adrianhelfer/Autocast/Utilities/USB_overlay.pdf

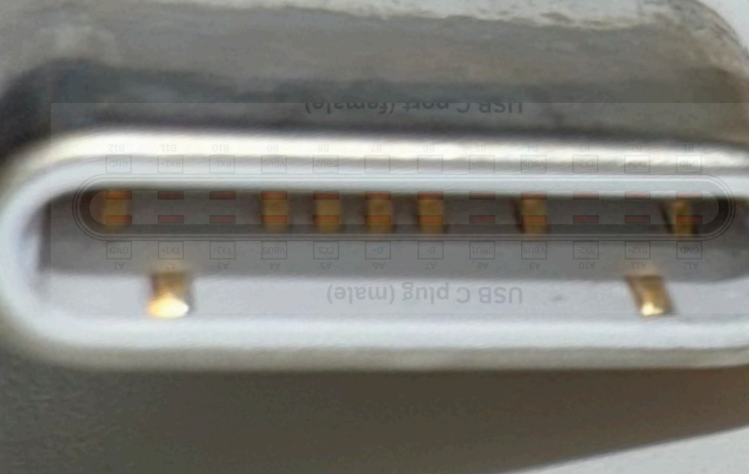
[picture p1: page 1]
