adrianhelfer/Autocast/Display/PCB_Label.png

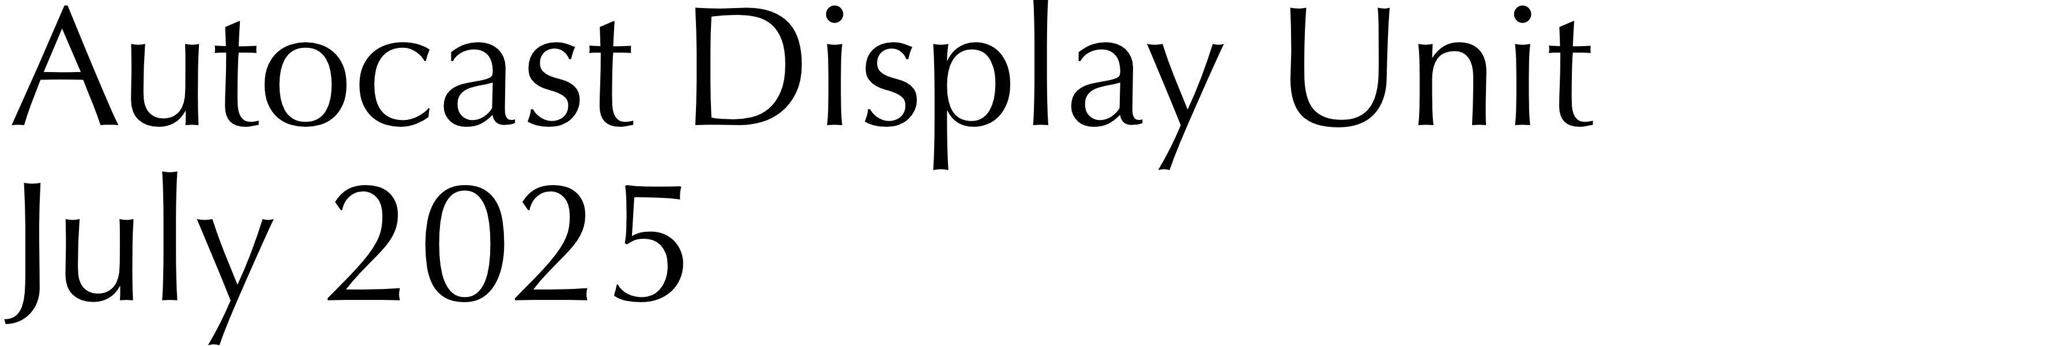
Display/PCB_Label.png
