adrianhelfer/Autocast/Display/PCB_Label_Caps.png

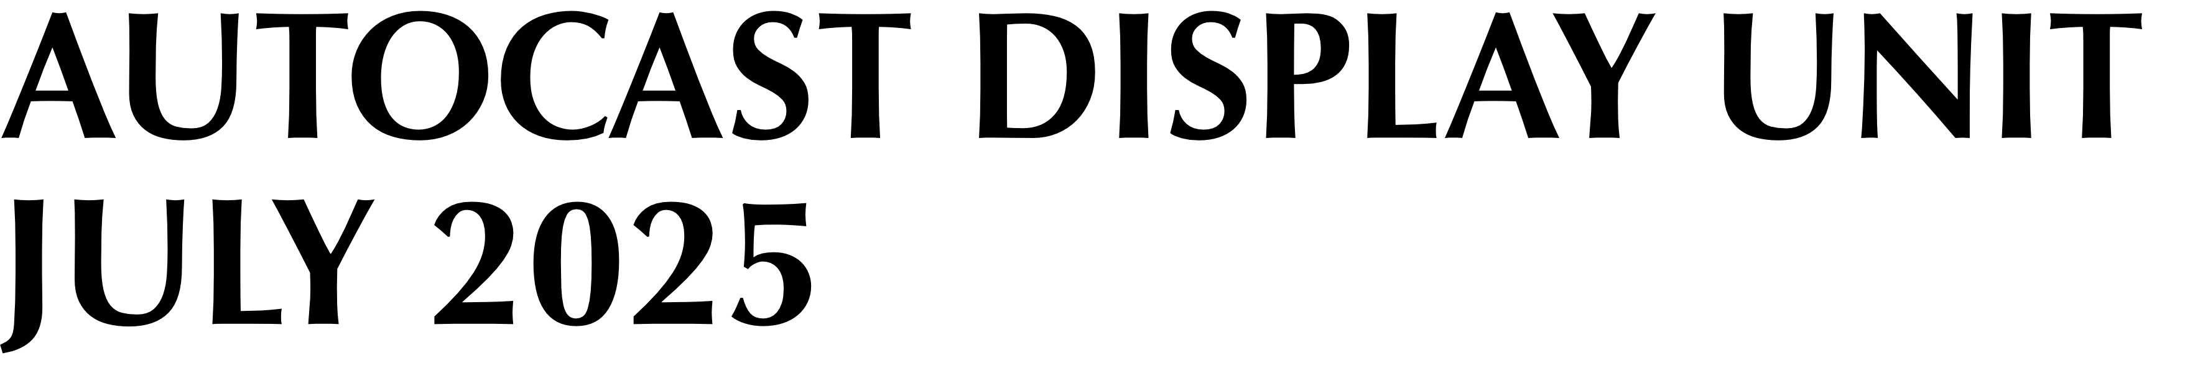
Display/PCB_Label_Caps.png
