adrianhelfer/Autocast/EVT/DAC_EVT/silkscreen/pcb_label.png

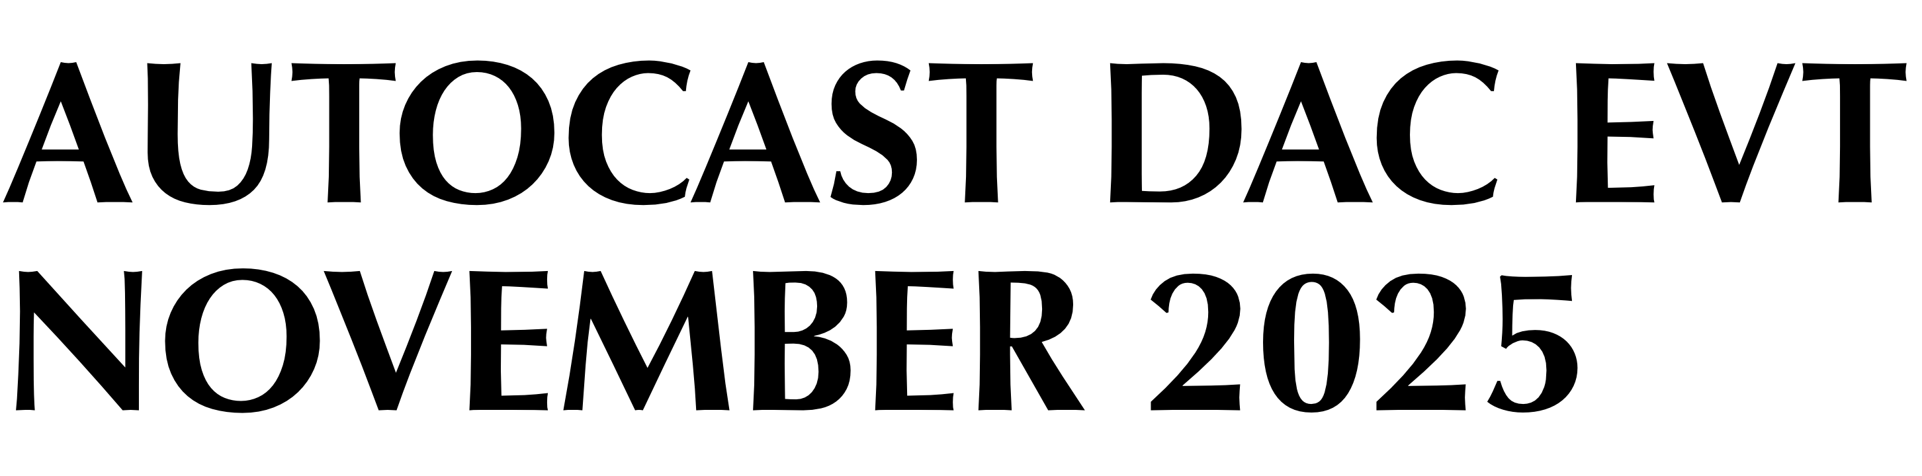
EVT/DAC_EVT/silkscreen/pcb_label.png
