adrianhelfer/Autocast/Playback_Control_EVT/PCB_label.png

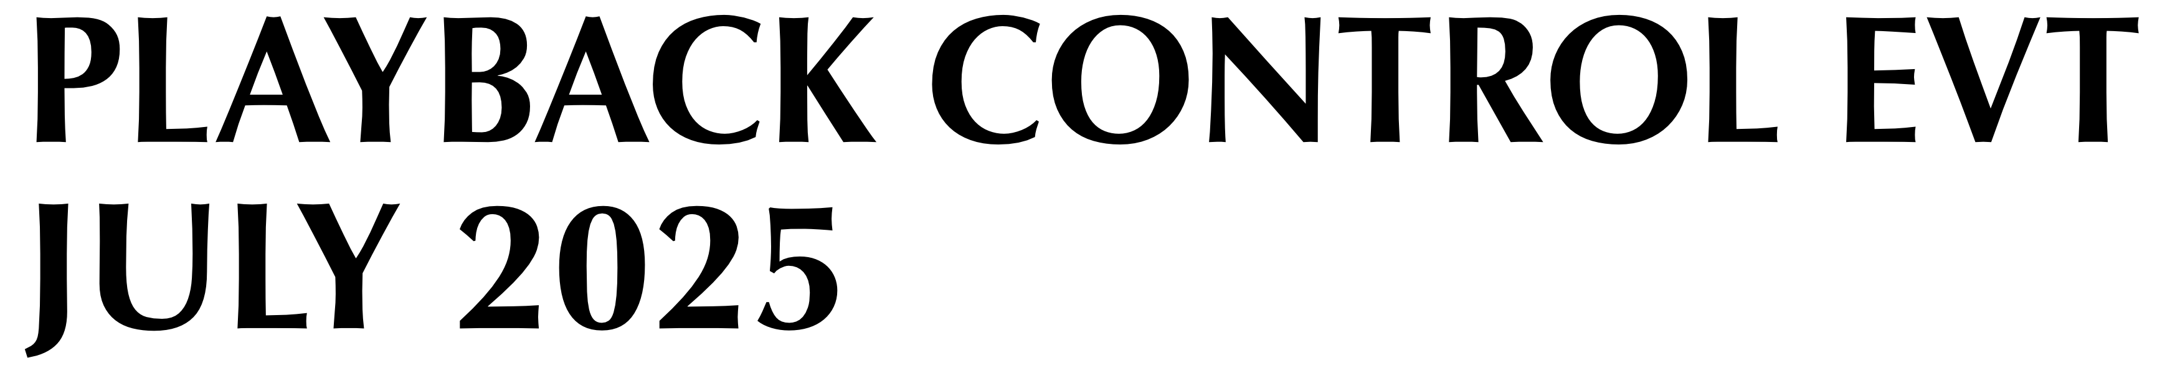
Playback_Control_EVT/PCB_label.png
