adrianhelfer/Autocast/Playback_Control_EVT/play_pause.png

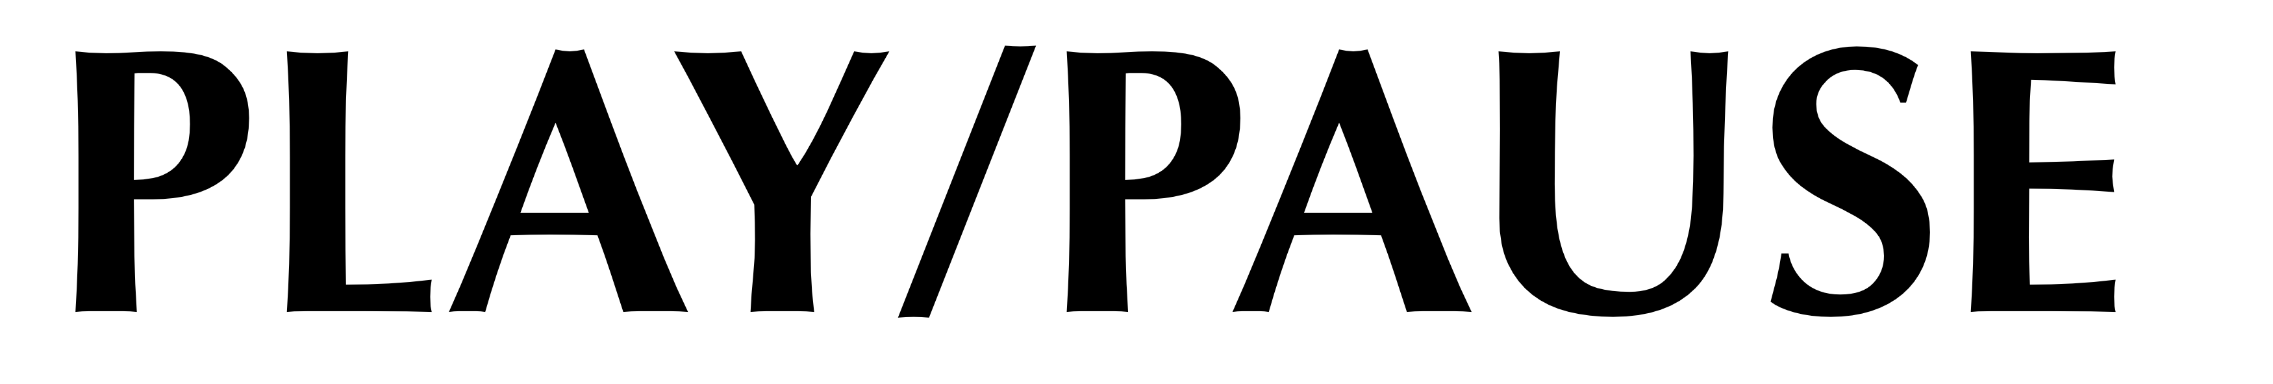
Playback_Control_EVT/play_pause.png
