adrianhelfer/Autocast/Playback_Control_EVT/rewind.png

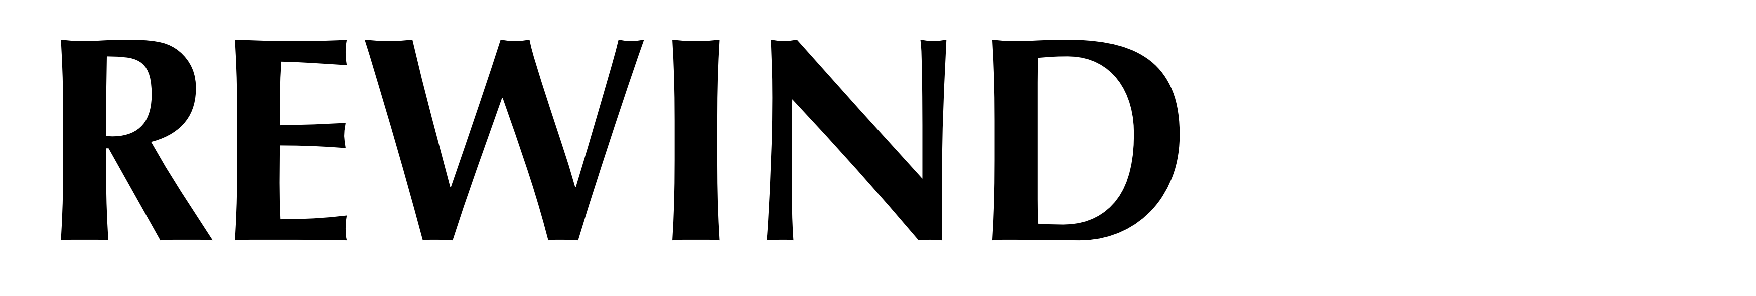
Playback_Control_EVT/rewind.png
