adrianhelfer/Autocast/Playback_Control_EVT/skip.png

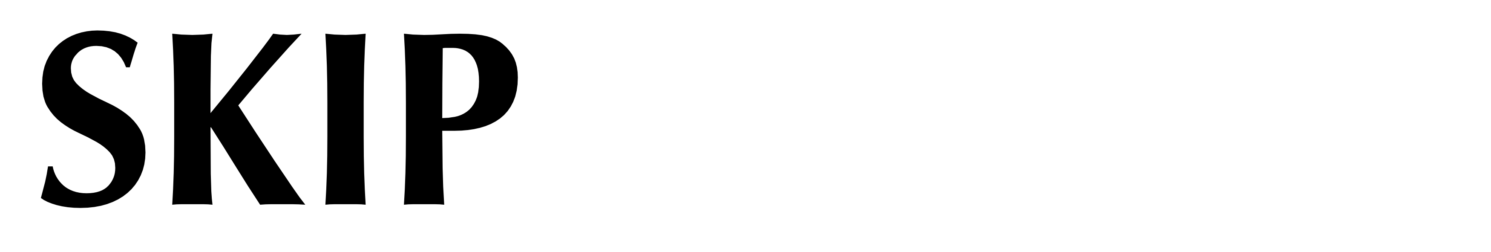
Playback_Control_EVT/skip.png
