adrianhelfer/Autocast/Playback_Control_EVT/vol_down.png

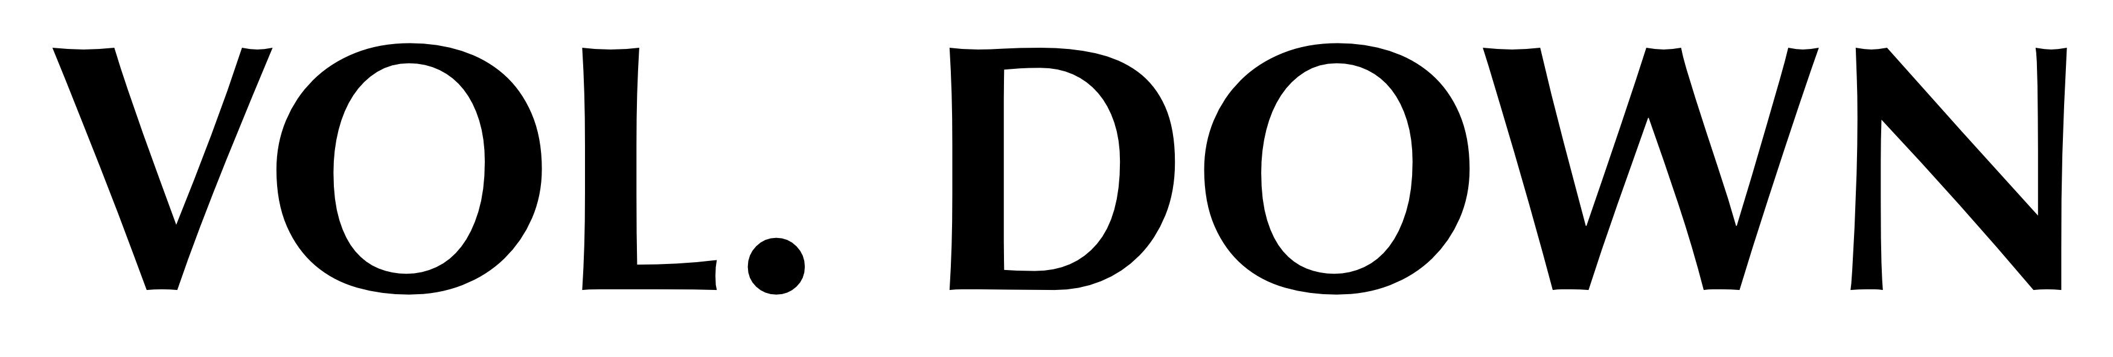
Playback_Control_EVT/vol_down.png
