adrianhelfer/Autocast/Playback_Control_EVT/vol_up.png

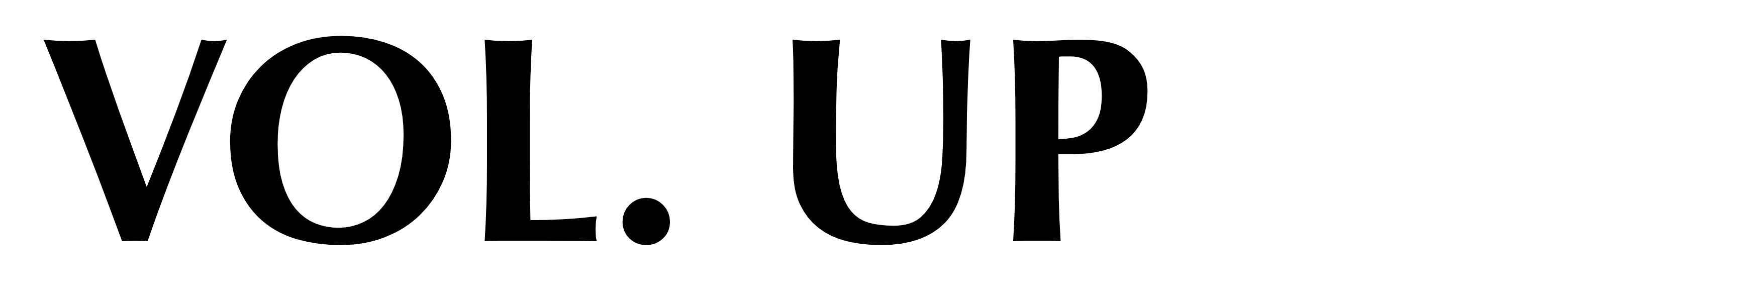
Playback_Control_EVT/vol_up.png
