adrianhelfer/Autocast/Utilities/ICSP/5843681079754166512_121.jpg

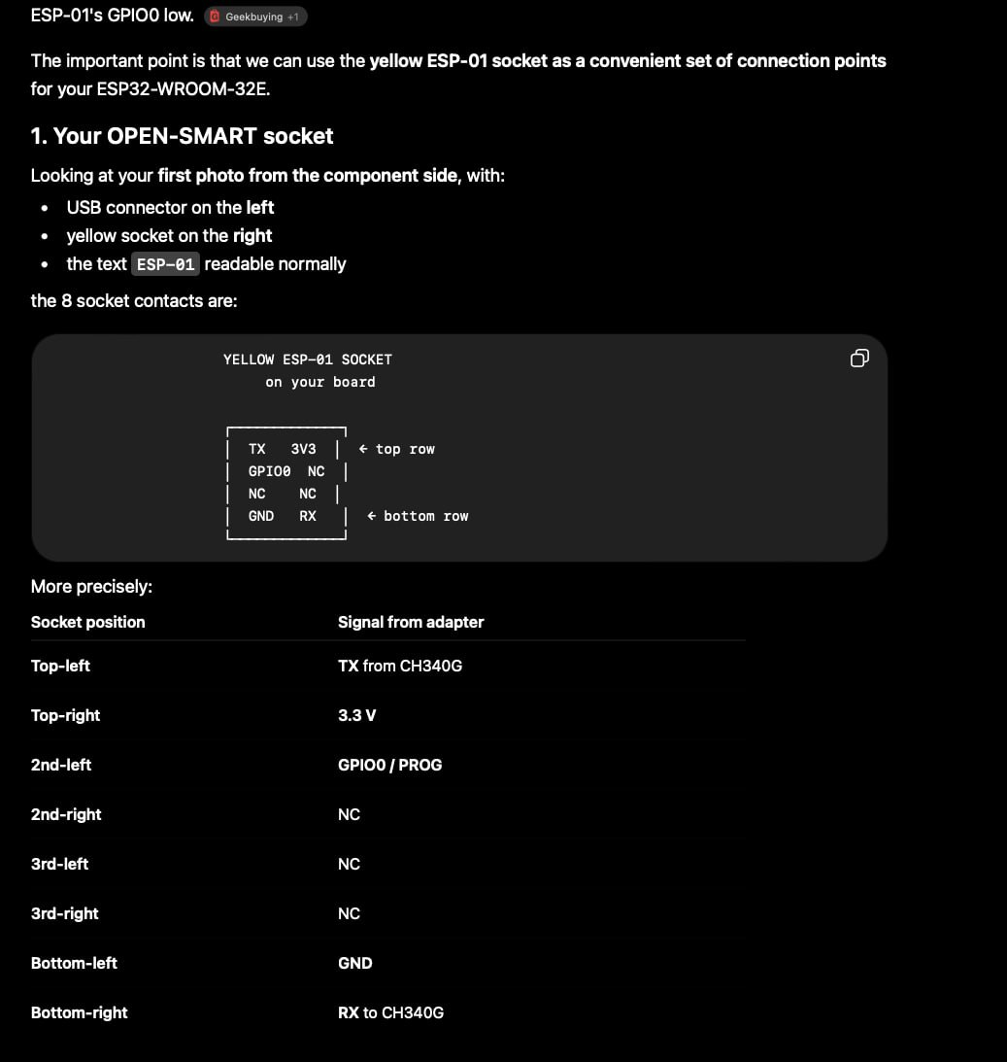
Utilities/ICSP/5843681079754166512_121.jpg
