adrianhelfer/Autocast/Utilities/ICSP/5843681079754166513_121.jpg

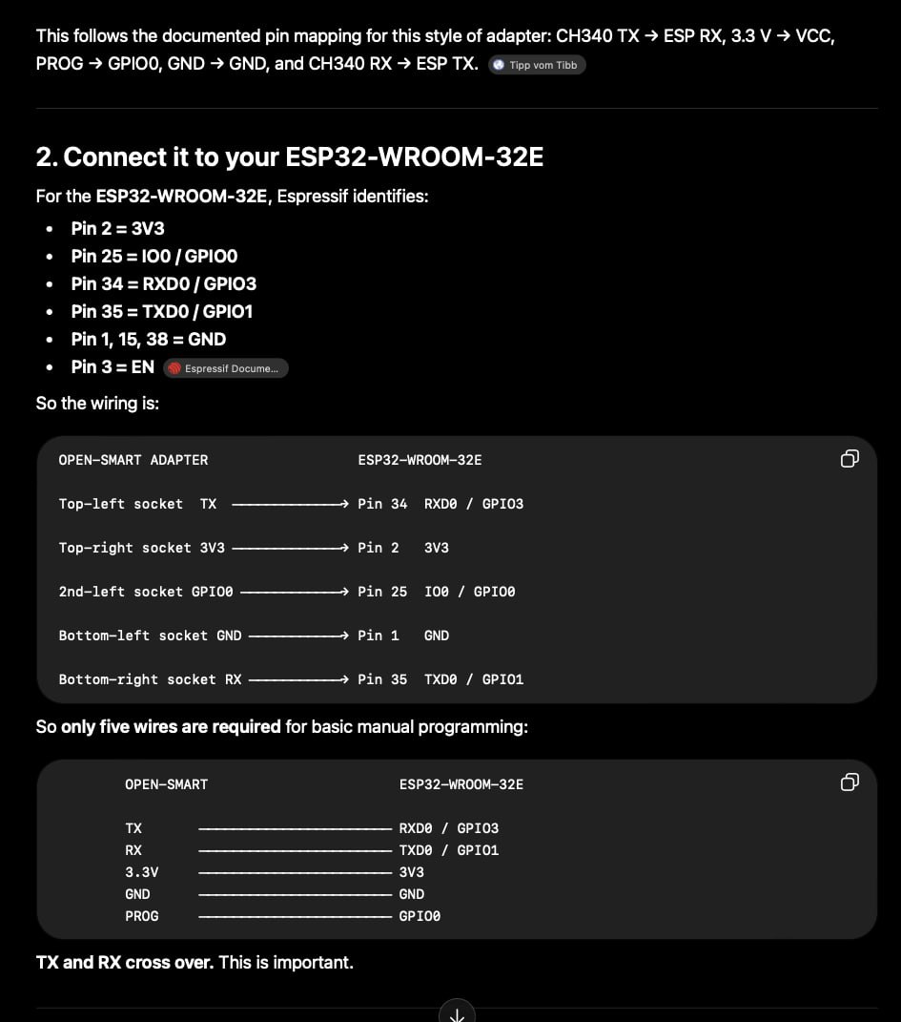
Utilities/ICSP/5843681079754166513_121.jpg
