adrianhelfer/Autocast/Utilities/ICSP/5843681079754166514_121.jpg

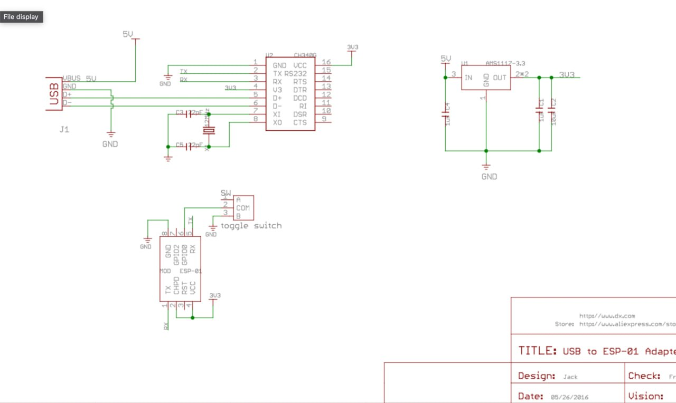
Utilities/ICSP/5843681079754166514_121.jpg
