adrianhelfer/Autocast/Utilities/ICSP/5843681079754166515_120.jpg

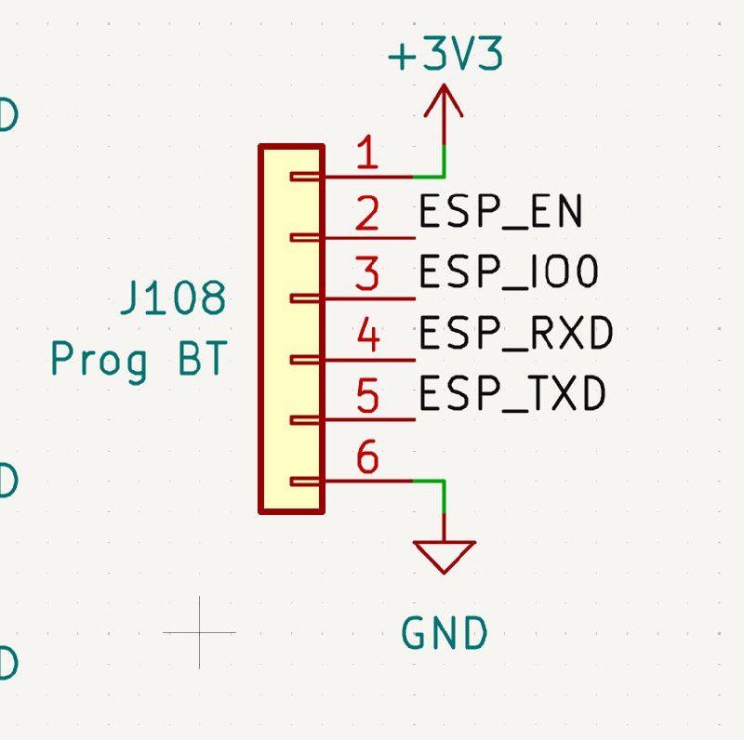
Utilities/ICSP/5843681079754166515_120.jpg
