adrianhelfer/Autocast/Display/production/bom.csv

Designator | Footprint | Quantity | Value | LCSC Part #
C1, C10, C11, C12, C13, C14, C15, C16, C17, C18, C19, C2, C20, C21, C22, C23, C24, C25, C26, C27, C28, C29, C3, C30, C31, C32, C33, C34, C35, C36, C37, C38, C39, C4, C40, C41, C42, C43, C44, C45, C46, C47, C48, C49, C5, C50, C51, C52, C53, C54, C55, C56, C6, C7, C8, C9 | 0201 | 56 | 100n | C49062
J1 | CON_2004850460_MOL | 1 | Conn_01x60
J2, J3 | CONN_12402032E202A_AMP | 2 | 12402032E202A
R1, R10, R100, R101, R102, R103, R104, R105, R106, R107, R108, R109, R11, R110, R111, R112, R113, R114, R115, R116, R117, R118, R119, R12, R120, R121, R122, R123, R124, R125, R126, R127, R128, R129, R13, R130, R131, R132, R133, R134, R135, R136, R137, R138, R139, R14, R140, R141, R142, R143, R144, R145, R146, R147, R148, R149, R15, R150, R151, R152, R153, R154, R155, R156, R157, R158, R159, R16, R160, R161, R162, R163, R164, R165, R166, R167, R168, R169, R17, R170, R171, R172, R173, R174, R175, R176, R177, R178, R179, R18, R180, R181, R182, R183, R184, R185, R186, R187, R188, R189, R19, R190, R191, R192, R193, R194, R195, R196, R197, R198, R199, R2, R20, R200, R201, R202, R203, R204, R205, R206, R207, R208, R209, R21, R210, R211, R212, R213, R214, R215, R216, R217, R218, R219, R22, R220, R221, R222, R223, R224, R225, R226, R227, R228, R229, R23, R230, R231, R232, R233, R234, R235, R236, R237, R238, R239, R24, R240, R241, R242, R243, R244, R245, R246, R247, R248, R249, R25, R250, R251, R252, R253, R254, R255, R256, R257, R258, R259, R26, R260, R261, R262, R263, R264, R265, R266, R267, R268, R269, R27, R270, R271, R272, R273, R274, R275, R276, R277, R278, R279 | 0402 | 200 | 100 | C25076
R28, R280, R281, R282, R283, R284, R285, R286, R287, R288, R289, R29, R290, R291, R292, R293, R294, R295, R296, R297, R298, R299, R3, R30, R300, R301, R302, R303, R304, R305, R306, R307, R308, R309, R31, R310, R311, R312, R313, R314, R315, R316, R317, R318, R319, R32, R320, R321, R322, R323, R324, R325, R326, R327, R328, R329, R33, R330, R331, R332, R333, R334, R335, R336, R337, R338, R339, R34, R340, R341, R342, R343, R344, R345, R346, R347, R348, R349, R35, R350, R351, R352, R353, R354, R355, R356, R357, R358, R359, R36, R360, R361, R362, R363, R364, R365, R366, R367, R368, R369, R37, R370, R371, R372, R373, R374, R375, R376, R377, R378, R379, R38, R380, R381, R382, R383, R384, R385, R386, R387, R388, R389, R39, R390, R391, R392, R393, R394, R395, R396, R397, R398, R399, R4, R40, R400, R401, R402, R403, R404, R405, R406, R407, R408, R409, R41, R410, R411, R412, R413, R414, R415, R416, R417, R418, R419, R42, R420, R43, R44, R45, R46, R47, R48, R49, R5, R50, R51, R52, R53, R54, R55, R56, R57, R58, R59, R6, R60, R61, R62, R63, R64, R65, R66, R67, R68, R69, R7, R70, R71, R72, R73, R74, R75, R76, R77, R78, R79, R8, R80 | 0402 | 200 | 100 | C25076
R81, R82, R83, R84, R85, R86, R87, R88, R89, R9, R90, R91, R92, R93, R94, R95, R96, R97, R98, R99 | 0402 | 20 | 100 | C25076
S1, S2, S3, S4, S5 | SW_TL2230EEF100 | 5 | TL2230EEF100
SEGD1, SEGD10, SEGD11, SEGD12, SEGD13, SEGD14, SEGD15, SEGD16, SEGD17, SEGD18, SEGD19, SEGD2, SEGD20, SEGD21, SEGD22, SEGD23, SEGD24, SEGD25, SEGD26, SEGD27, SEGD28, SEGD3, SEGD4, SEGD5, SEGD6, SEGD7, SEGD8, SEGD9 | ACPSC04-41SEKWA | 28 | ~
U1, U10, U11, U12, U13, U14, U15, U16, U17, U18, U19, U2, U20, U21, U22, U23, U24, U25, U26, U27, U28, U29, U3, U30, U31, U32, U33, U34, U35, U36, U37, U38, U39, U4, U40, U41, U42, U43, U44, U45, U46, U47, U48, U49, U5, U50, U51, U52, U53, U54, U55, U56, U6, U7, U8, U9 | TSSOP-16_4.4x5mm_P0.65mm | 56 | 74HC595
