adrianhelfer/Autocast/mCAD/Display-Assembly.FCStd

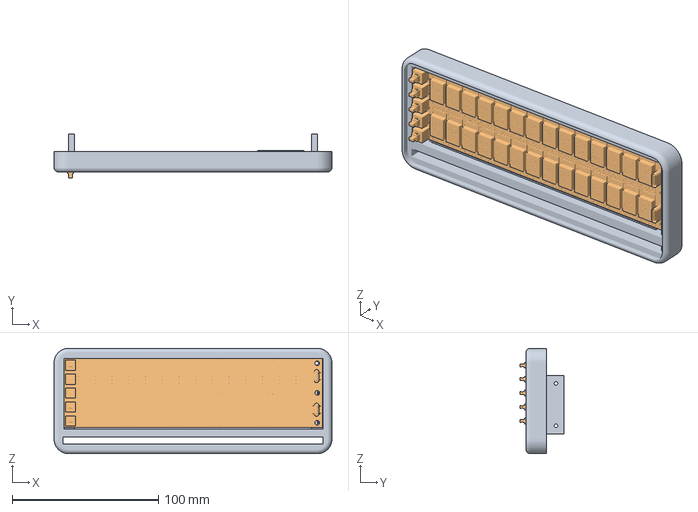
[picture p15: CAD file, 2026-10-08]
mCAD/Display-Assembly.FCStd
190.0 x 30.1 x 72.0 mm
Display001
