adrianhelfer/Autocast/Display/3D-Models/ACPSX04-41.STEP

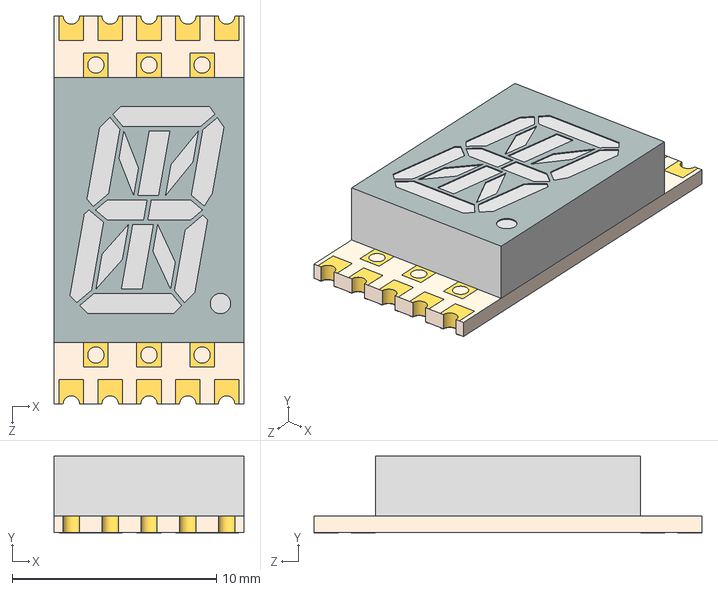
[picture p16: CAD file, 2025-07-09]
Display/3D-Models/ACPSX04-41.STEP
9.30 x 3.77 x 19.0 mm
