adrianhelfer/Autocast/EVT/DAC_EVT/3d_models/SMV_z90.stp

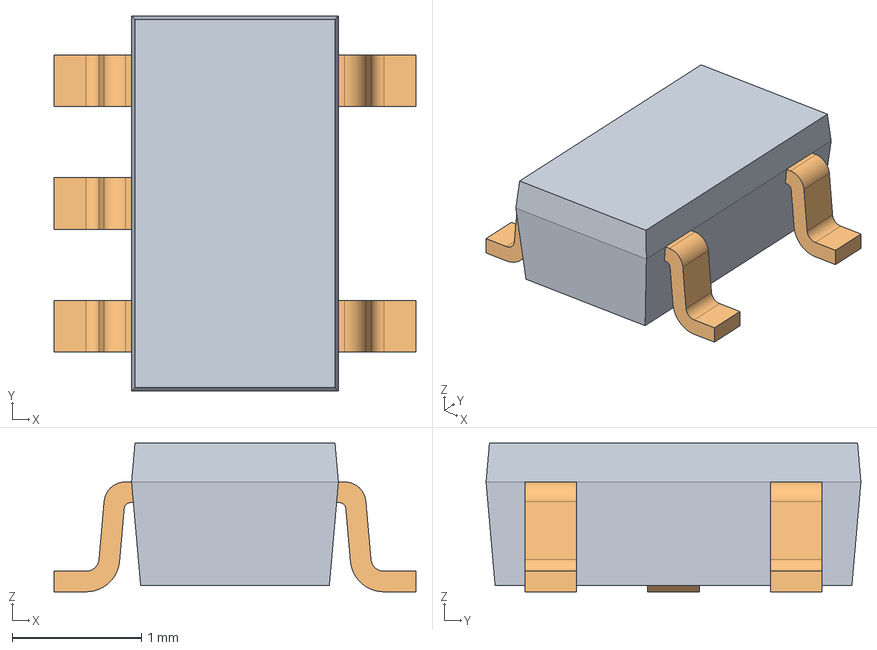
[picture p17: CAD file, 2025-11-18]
EVT/DAC_EVT/3d_models/SMV_z90.stp
2.80 x 2.90 x 1.15 mm
