adrianhelfer/Autocast/EVT/Lever_EVT/Slider.step

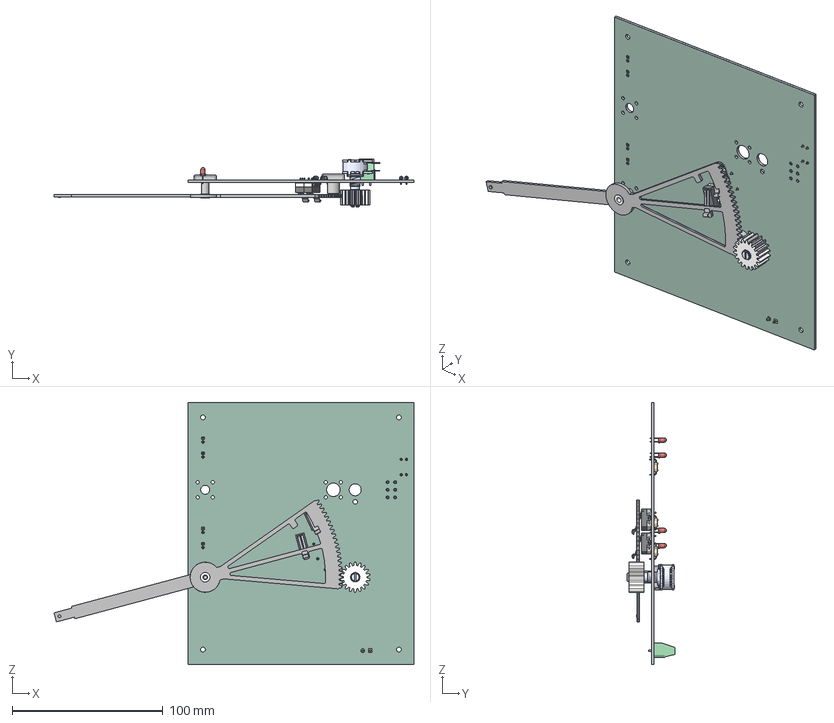
[picture p18: CAD file, 2026-09-19]
EVT/Lever_EVT/Slider.step
238.8 x 31.6 x 174.0 mm
Spur Gear (18 teeth)
Spur Gear (18 teeth) (1)
Spur Gear (180 teeth)
PTN16_2 BUSHING
PTN16-A_2 HOUSING
PTN16_20K1_SHAFT
R_Axial_DIN0207_L6.3mm_D2.5mm_P10.16mm_Horizontal x 4
TerminalBlock_Phoenix_MKDS-1,5-2_1x02_P5.00mm_Horizontal
LED_D3.0mm x 4
Bottom001 x 2
Top001 x 2
Plunger001 x 2
Lever_16U001 x 2
Pin_NO005 x 2
Pin_C005 x 2
Pin_NC005 x 2
Lever_EVT_copper
Lever_EVT_silkscreen
Lever_EVT_silkscreen_1
Lever_EVT_soldermask
Lever_EVT_soldermask_1
Lever_EVT_PCB
