adrianhelfer/Autocast/EVT/USB_Audio_EVT/3d-models/CSTNE12M0G55A000R0.step

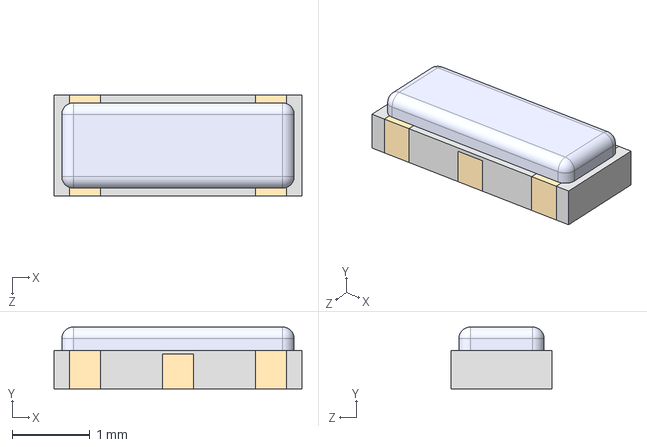
[picture p19: CAD file, 2026-09-19]
EVT/USB_Audio_EVT/3d-models/CSTNE12M0G55A000R0.step
3.20 x 0.8 x 1.30 mm
