adrianhelfer/Autocast/mCAD/button-caps/play-pause.FCStd

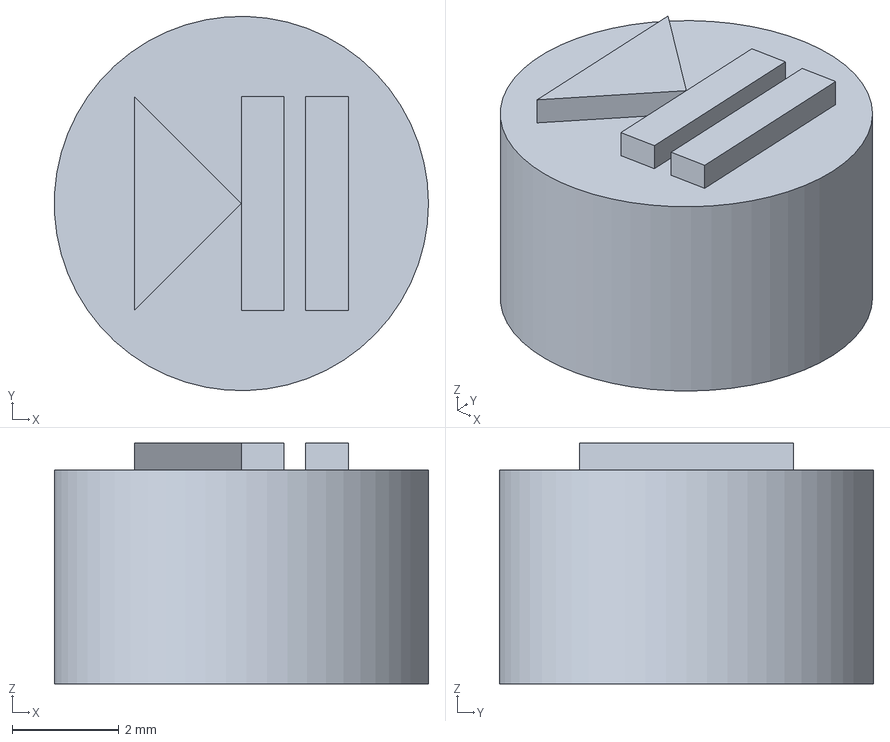
[picture p20: CAD file, 2026-10-08]
mCAD/button-caps/play-pause.FCStd
6.99 x 7.00 x 4.50 mm
