adrianhelfer/Autocast/mCAD/slide-selector/potentiometer_attachment-Body.stl

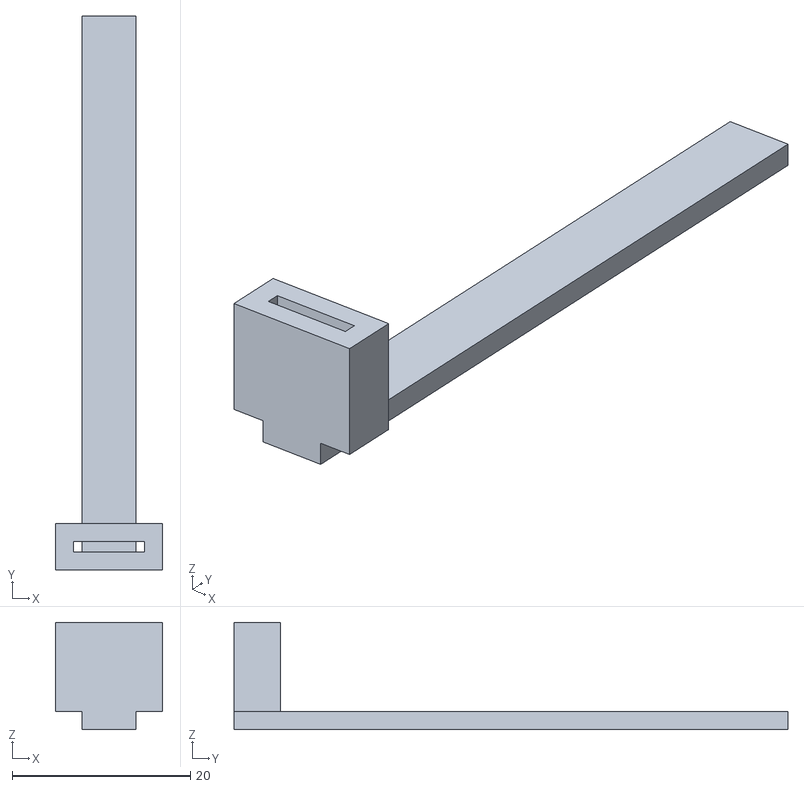
[picture p21: CAD file, 2026-10-06]
mCAD/slide-selector/potentiometer_attachment-Body.stl
12.0 x 62.1 x 12.0
