adrianhelfer/Autocast/PSU_EVT/3D_Models/STL6P3LLH6.step

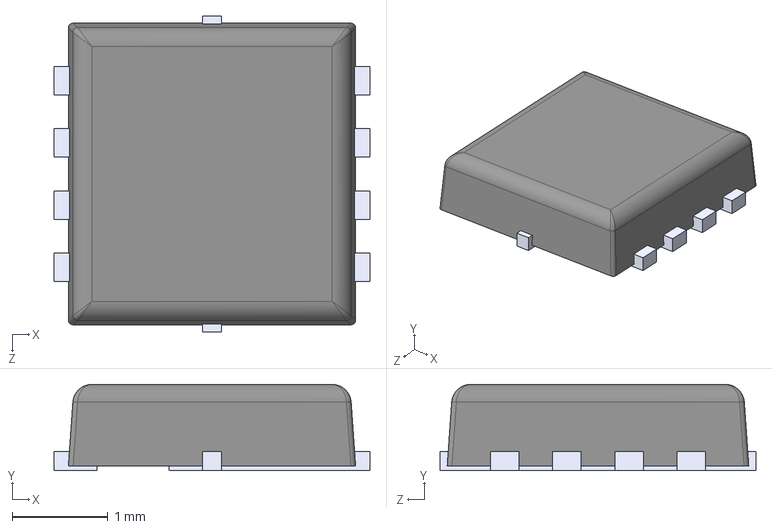
[picture p22: CAD file, 2025-07-14]
PSU_EVT/3D_Models/STL6P3LLH6.step
3.30 x 0.9 x 3.30 mm
