adrianhelfer/Autocast/EVT/DAC_EVT/3d_models/SJ1-3523N.step

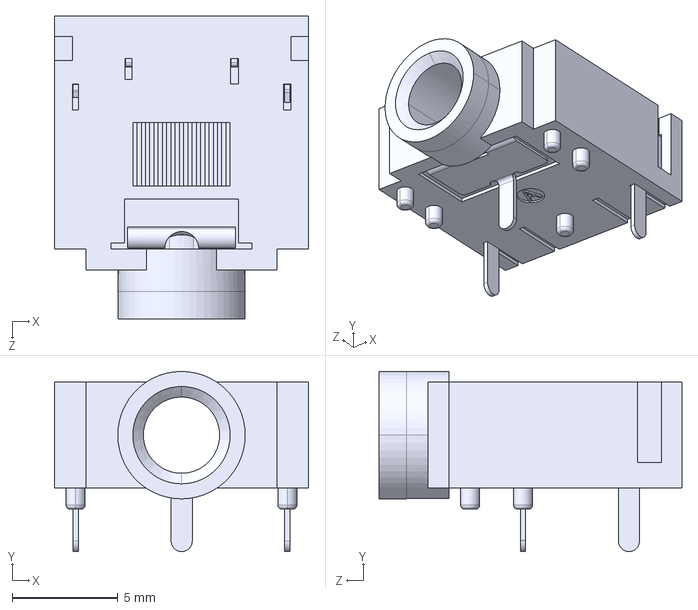
[picture p23: CAD file, 2025-11-18]
EVT/DAC_EVT/3d_models/SJ1-3523N.step
12.0 x 8.51 x 14.3 mm
