adrianhelfer/Autocast/EVT/Lever_EVT/Lever_EVT.step

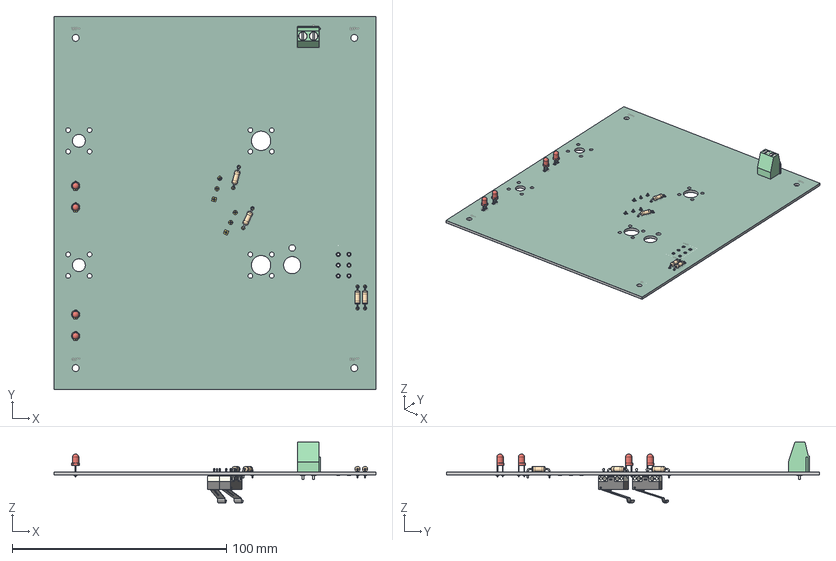
[picture p24: CAD file, 2026-09-19]
EVT/Lever_EVT/Lever_EVT.step
150.0 x 174.0 x 28.3 mm
R_Axial_DIN0207_L6.3mm_D2.5mm_P10.16mm_Horizontal x 4
TerminalBlock_Phoenix_MKDS-1,5-2_1x02_P5.00mm_Horizontal
LED_D3.0mm x 4
Bottom001 x 2
Top001 x 2
Plunger001 x 2
Lever_16U001 x 2
Pin_NO005 x 2
Pin_C005 x 2
Pin_NC005 x 2
Lever_EVT_copper
Lever_EVT_silkscreen x 2
Lever_EVT_soldermask x 2
Lever_EVT_PCB
