adrianhelfer/Autocast/EVT/USB_Audio_EVT/3d-models/PCM2706CPJTR.step

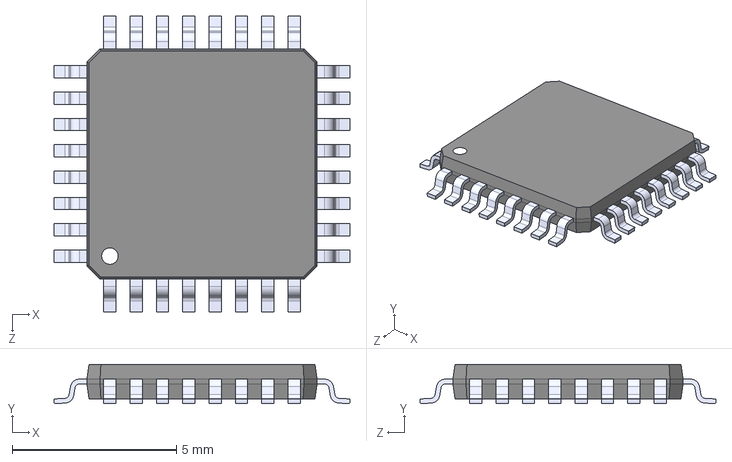
[picture p25: CAD file, 2026-09-19]
EVT/USB_Audio_EVT/3d-models/PCM2706CPJTR.step
9.00 x 1.20 x 9.00 mm
