adrianhelfer/Autocast/mCAD/button-caps/plus.FCStd

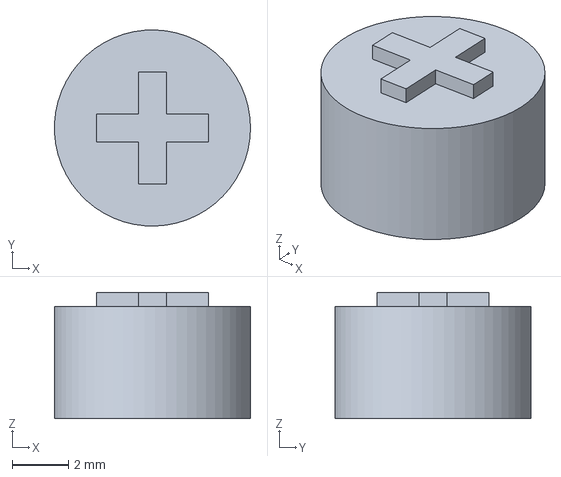
[picture p26: CAD file, 2026-10-08]
mCAD/button-caps/plus.FCStd
6.99 x 7.00 x 4.50 mm
