adrianhelfer/Autocast/mCAD/Display-Glass.FCStd

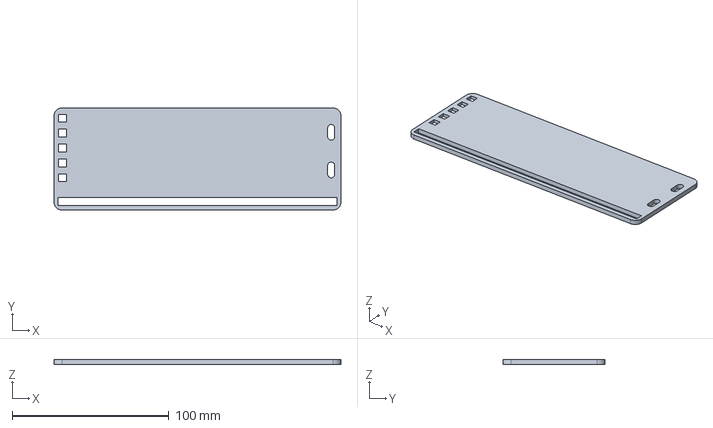
[picture p27: CAD file, 2026-10-08]
mCAD/Display-Glass.FCStd
183.0 x 65.0 x 3.00 mm
