adrianhelfer/Autocast/mCAD/slide-selector/carriage_attachment-Body.stl

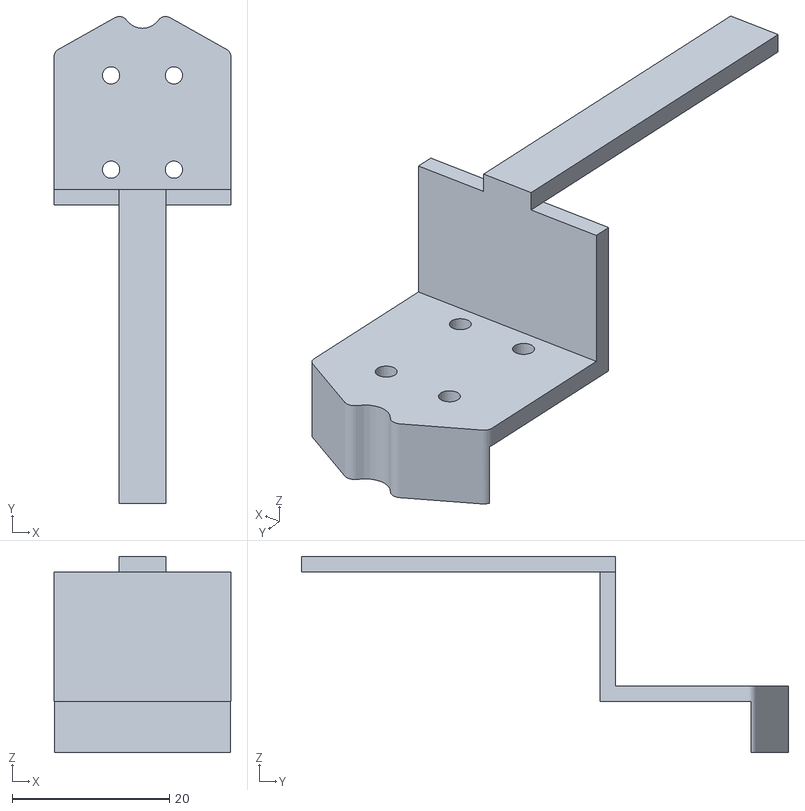
[picture p28: CAD file, 2026-10-06]
mCAD/slide-selector/carriage_attachment-Body.stl
22.5 x 62.0 x 25.0
