adrianhelfer/Autocast/EVT/USB_Audio_EVT/3d-models/TL2230EEF100.STEP

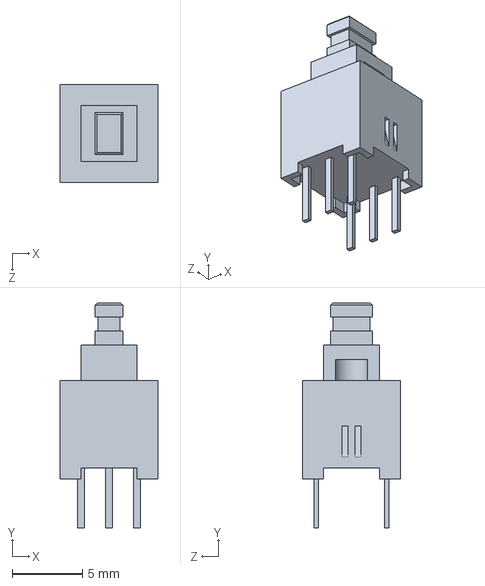
[picture p29: CAD file, 2025-07-09]
EVT/USB_Audio_EVT/3d-models/TL2230EEF100.STEP
7.00 x 16.0 x 7.00 mm
