adrianhelfer/Autocast/(list of files, cad)

Other CAD files:
mCAD/button-caps/rewind.FCStd
mCAD/slide-selector/carriage_attachment.FCStd
mCAD/button-caps/minus.FCStd
mCAD/button-caps/forward.FCStd
Display/3D-Models/2004850460.stp
EVT/Lever_EVT/Slider.f3z
EVT/USB_Audio_EVT/3d-models/12402032E202A.STEP
mCAD/Display-Assembly.stl
mCAD/Display-Glass.stl
mCAD/button-caps/forward.stl
mCAD/button-caps/minus.stl
mCAD/button-caps/play-pause.stl
mCAD/button-caps/plus.stl
mCAD/button-caps/rewind.stl
