adrianhelfer/Autocast/Utilities/Radio_Wiring.pdf

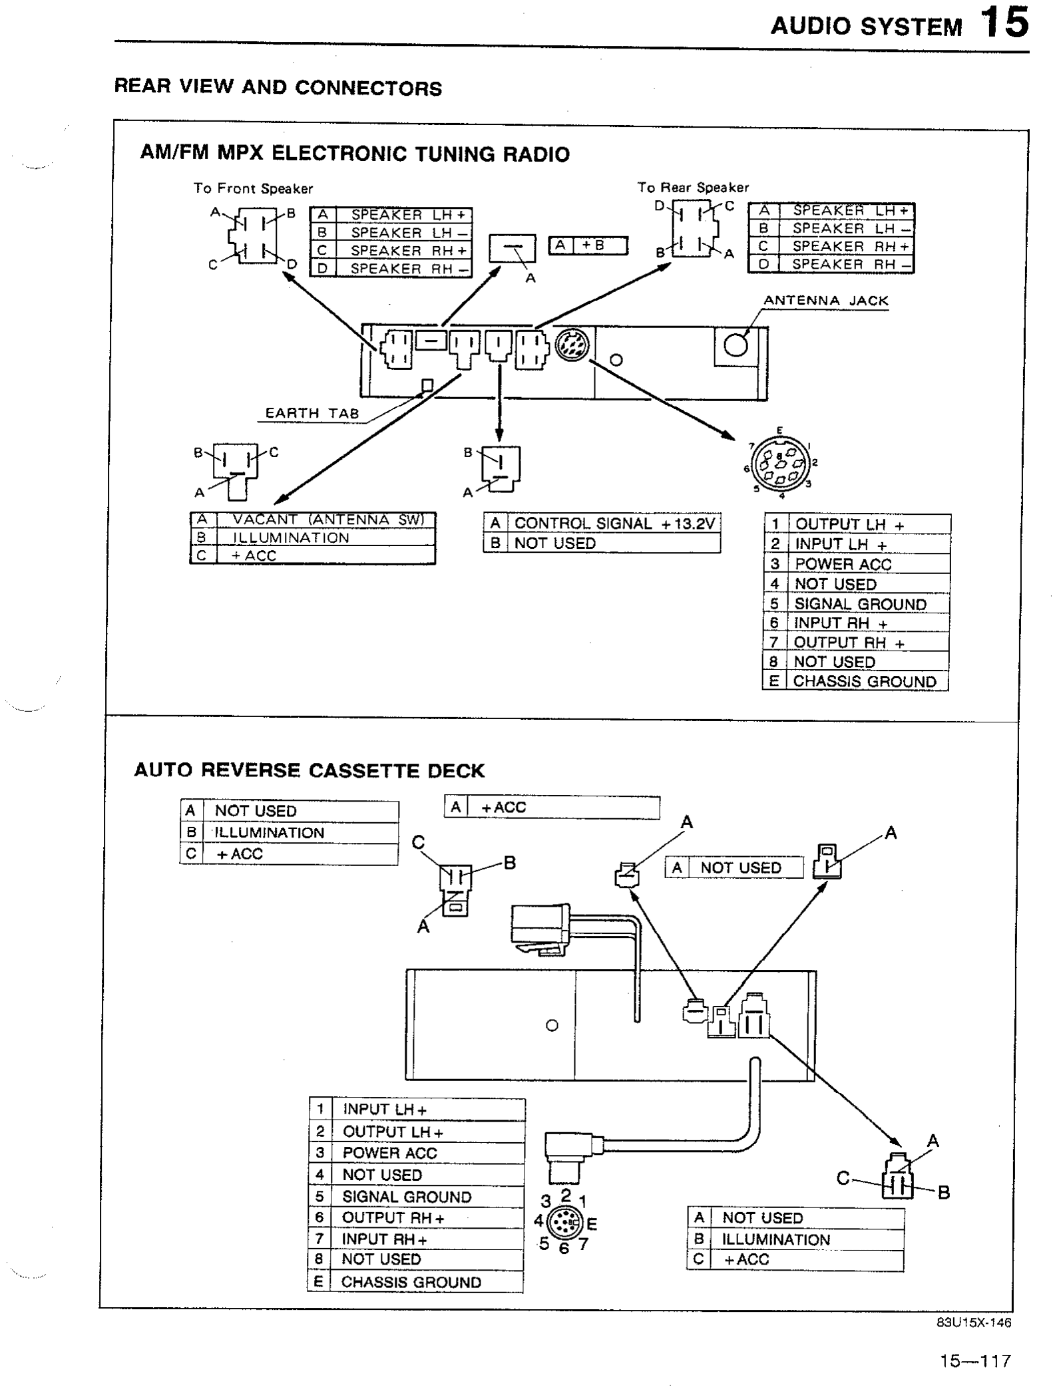
[picture p30: page 1]

AUDIO | SYSTEM | 15

REAR VIEW AND CONNECTORS

AM/FM | MPX ELECTRONIC | TUNING | RADIO
TO Front Speaker | To Rear Speaker
AUTO | REVERSECASSETTEDECK

83”15X-14

15-117
