adrianhelfer/Autocast/EVT/USB_Audio_EVT/fabrication/layers.pdf

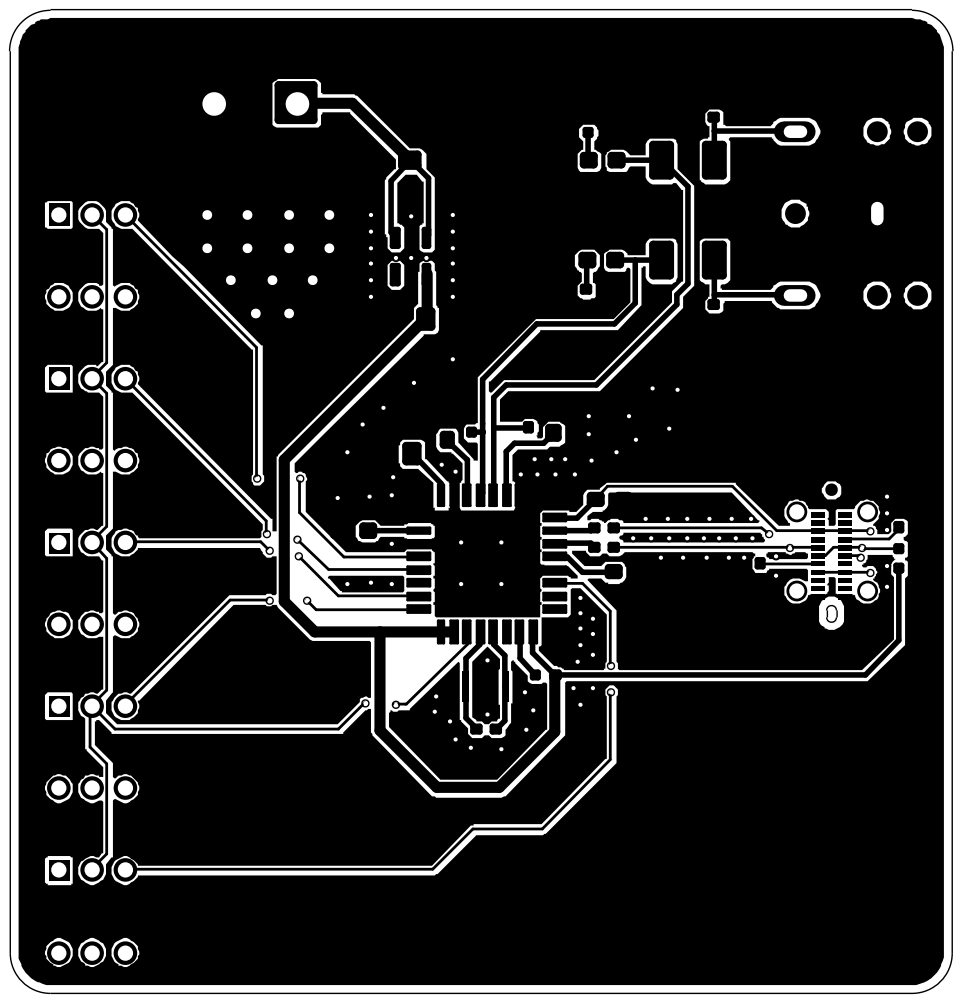
[picture p31: page 1]

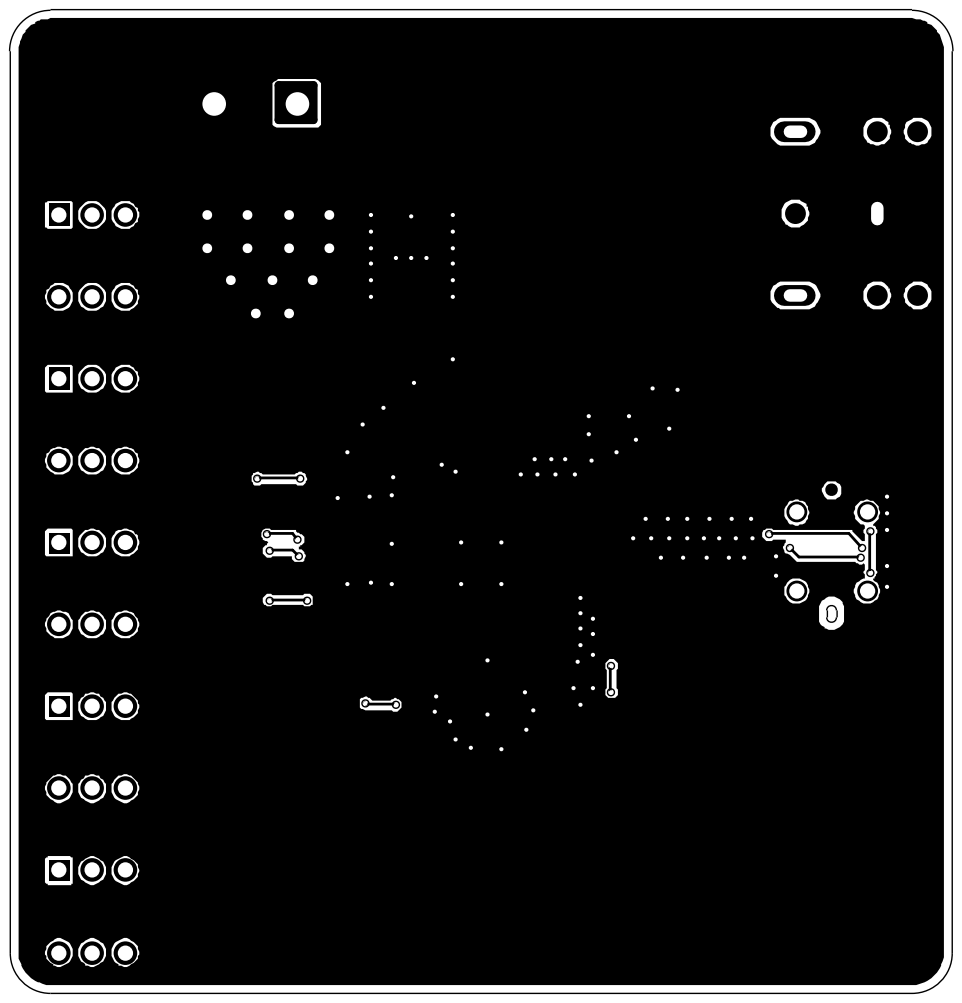
[picture p32: page 2]
