adrianhelfer/Autocast/Utilities/display_drawings.pdf

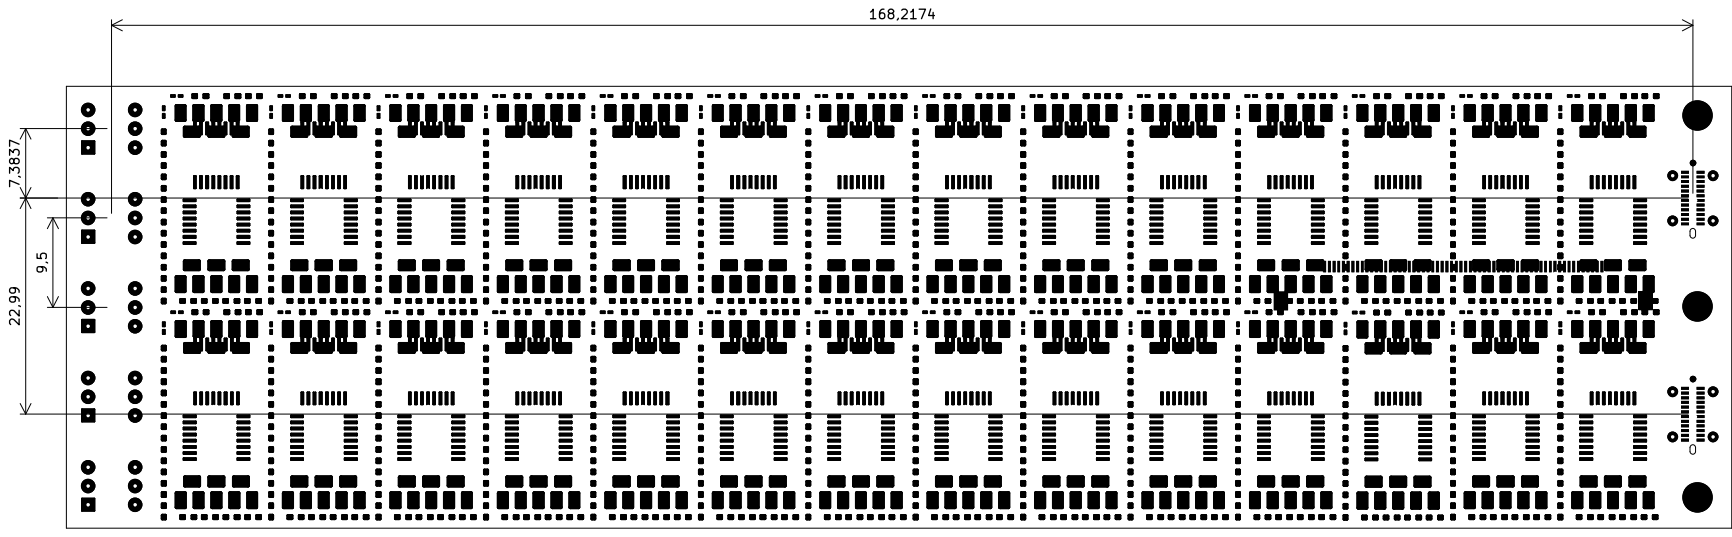
[picture p33: page 1]
