adrianhelfer/Autocast/Software/Autocast/Autocast.ino

#include <Arduino.h>
#include <Wire.h>
#include "BluetoothA2DPSink.h"
#include "AutocastDisplay.h"

// USB current monitor
#define USB_POWER_MONITOR_SDA_PIN 32
#define USB_POWER_MONITOR_SCL_PIN 33
#define INA226_ADDR 0x40          // Default address (A0=A1=GND)
#define SHUNT_RESISTOR_OHMS 0.01  // 0.01 ohm shunt
#define MAX_EXPECTED_USB_CURRENT_A 3.2

// ---------- INA226 register map ----------
#define INA226_REG_CONFIG 0x00
#define INA226_REG_SHUNT_V 0x01
#define INA226_REG_BUS_V 0x02
#define INA226_REG_POWER 0x03
#define INA226_REG_CURRENT 0x04
#define INA226_REG_CALIBRATION 0x05

float INA226_currentLSB;  // Amps per bit for the current register
float INA226_powerLSB;    // Watts per bit for the power register
int success = 0;
// ---------------------------------------------------------------------
// Pin definitions
// ---------------------------------------------------------------------
const uint8_t SENSOR_VP_PIN = 36;  // adjust to your actual wiring
const uint8_t SENSOR_VN_PIN = 39;

const int CONFIG_PIN_SER = 2;     // IO2  -> SER (serial data in)
const int CONFIG_PIN_SRCLK = 17;  // IO17 -> SRCLK (shift register clock)
const int CONFIG_PIN_RCLK = 13;   // IO13 -> RCLK (storage register clock / latch)

const int ILLUMINATION_SIGNAL_PIN = 4;  // HIGH when headlights or parking lights are switched on
const int DIMM_DISPLAY_PIN = 15;        // Display gets darker when set to HIGH

const int USB_DAC_CABLE_DETECT_A = 19;
const int USB_DAC_CABLE_DETECT_B = 21;

// Button order matches schematic but not the physical layout due to routing optimization
const int USER_BUTTON_1 = 12;
const int USER_BUTTON_2 = 14;
const int USER_BUTTON_3 = 27;
const int USER_BUTTON_4 = 34;
const int USER_BUTTON_5 = 35;

// ---- Bluetooth button configuration ----
// Set to LOW if your buttons pull the line to GND when pressed.
#define BUTTON_ACTIVE_LEVEL HIGH

const uint8_t BT_BTN_PREV = USER_BUTTON_1;
const uint8_t BT_BTN_PLAYPAUSE = USER_BUTTON_2;
const uint8_t BT_BTN_NEXT = USER_BUTTON_5;
const uint8_t BT_BTN_VOL_DOWN = USER_BUTTON_4;
const uint8_t BT_BTN_VOL_UP = USER_BUTTON_3;

const uint8_t BT_VOLUME_STEP = 10;
const unsigned long BT_REPEAT_DELAY_MS = 400;     // hold time before repeating
const unsigned long BT_REPEAT_INTERVAL_MS = 150;  // repeat rate while held

bool bt_is_connected = false;
bool bt_is_playing = false;

static const uint8_t BT_BUTTON_PINS[5] = {
  USER_BUTTON_1, USER_BUTTON_2, USER_BUTTON_3, USER_BUTTON_4, USER_BUTTON_5
};
static bool btn_last[5] = { false, false, false, false, false };
static unsigned long btn_press_time[5] = { 0, 0, 0, 0, 0 };
static unsigned long btn_last_repeat[5] = { 0, 0, 0, 0, 0 };

// Amplifier failure
const int AMP_FAIL_PIN = 16;

// =======================================================================
// TYPE DEFINITIONS (must precede all forward declarations / function use)
// =======================================================================

// ---- Top-level input selection state ----
enum class InputSelection : uint8_t {
  OFF,
  BLUETOOTH,
  USB,
  ERROR_STATE
};

// ---- Bits to shift into the configuration register ----
enum config_t {
  OFF_CONFIG = 0b00000000,
  BLUETOOTH_CONFIG = 0b00001011,
  USB_CONFIG = 0b00001111,  // USB DAC not on by default
  USB_DAC_EN_BITMASK = 0b00010000
} current_config;

// ---- Bluetooth-mode-local display state ----
enum bt_display_information_t {
  BT_NOT_CONNECTED,
  BT_NOW_PLAYING,
  BT_VOLUME_OVERLAY
};

struct TrackInfo {
  String title = "";
  String artist = "";
};

// =======================================================================
// FORWARD DECLARATIONS
// =======================================================================

// ---- State machine core ----
InputSelection decodeState(int vpState, int vnState);
void enterState(InputSelection s);
void exitState(InputSelection s);
void runState(InputSelection s);

// ---- OFF ----
void enterOffMode();
void exitOffMode();
void runOffMode();

// ---- BLUETOOTH ----
void enterBluetoothMode();
void exitBluetoothMode();
void runBluetoothMode();
void avrc_metadata_callback(uint8_t id, const uint8_t* text);
void connection_state_changed(esp_a2d_connection_state_t state, void* ptr);
void audio_state_changed(esp_a2d_audio_state_t state, void* ptr);

// ---- USB ----
void enterUsbMode();
void exitUsbMode();
void runUsbMode();

// ---- ERROR ----
void enterErrorMode();
void exitErrorMode();
void runErrorMode();

void shiftOutByte(uint8_t data, bool msbFirst = true) {
  for (int i = 0; i < 8; i++) {
    // Pick the correct bit depending on shift order
    uint8_t bit = msbFirst ? ((data >> (7 - i)) & 0x01)
                           : ((data >> i) & 0x01);

    digitalWrite(CONFIG_PIN_SER, bit);

    // Pulse SRCLK to shift the bit in
    digitalWrite(CONFIG_PIN_SRCLK, HIGH);
    delayMicroseconds(1);  // tiny settle time, optional at low speed
    digitalWrite(CONFIG_PIN_SRCLK, LOW);
  }

  // Latch the shifted data to the output pins
  digitalWrite(CONFIG_PIN_RCLK, HIGH);
  delayMicroseconds(1);
  digitalWrite(CONFIG_PIN_RCLK, LOW);
}


void load_config(config_t config) {
  current_config = config;
  shiftOutByte(config);
}

void enable_usb_dac() {
  load_config((config_t)(current_config | USB_DAC_EN_BITMASK));
}


void disable_usb_dac() {
  load_config((config_t)(current_config & ~USB_DAC_EN_BITMASK));
}

void ina226Write16(uint8_t reg, uint16_t value) {
  Wire.beginTransmission(INA226_ADDR);
  Wire.write(reg);
  Wire.write((value >> 8) & 0xFF);  // MSB first
  Wire.write(value & 0xFF);
  Wire.endTransmission();
}

int16_t ina226Read16(uint8_t reg) {
  Wire.beginTransmission(INA226_ADDR);
  Wire.write(reg);
  Wire.endTransmission(false);
  Wire.requestFrom(INA226_ADDR, (uint8_t)2);
  uint16_t value = 0;
  if (Wire.available() >= 2) {
    value = (Wire.read() << 8) | Wire.read();
  }
  return (int16_t)value;
}

void setupINA226() {
  // Current_LSB = MaxExpectedCurrent / 2^15
  INA226_currentLSB = MAX_EXPECTED_USB_CURRENT_A / 32768.0;
  INA226_powerLSB = INA226_currentLSB * 25.0;  // Power_LSB = 25 * Current_LSB (per datasheet)

  // Calibration = 0.00512 / (Current_LSB * Rshunt)
  uint16_t calValue = (uint16_t)(0.00512 / (INA226_currentLSB * SHUNT_RESISTOR_OHMS));
  ina226Write16(INA226_REG_CALIBRATION, calValue);

  // Config register: default reset value 0x4127 gives
  // avg=1, bus/shunt conv time=1.1ms, continuous shunt+bus mode.
  // Increase averaging for smoother readings, e.g. 0x4527 (avg=16).
  ina226Write16(INA226_REG_CONFIG, 0x4527);
  delay(100);
}


// =======================================================================
// GLOBALS
// =======================================================================

InputSelection autocast_input_selection = InputSelection::OFF;

// ---- Debounce configuration ----
const uint8_t DEBOUNCE_THRESHOLD = 5;         // consecutive agreeing samples required
const unsigned long SAMPLE_INTERVAL_MS = 10;  // time between samples, ms

static InputSelection candidateState = InputSelection::OFF;
static uint8_t debounceCounter = 0;
static unsigned long lastSampleTime = 0;

// ---- Bluetooth (A2DP sink) globals ----
BluetoothA2DPSink a2dp_sink;
AutocastDisplay display;  // shared display hardware, used by any mode

int bt_last_volume, bt_current_volume;
TrackInfo currentTrack;

bt_display_information_t bt_display_information = BT_NOT_CONNECTED;

String bt_top_display_content;
String bt_bottom_display_content;

const uint16_t BT_OVERLAY_DURATION_MS = 1000;
unsigned long bt_overlay_timestamp = 0;
bool bt_overlay_on = false;

// =======================================================================
// STATE MACHINE CORE
// =======================================================================

InputSelection decodeState(int vpState, int vnState) {
  bool vp = (vpState != LOW);
  bool vn = (vnState != LOW);

  if (vp && vn) return InputSelection::OFF;
  else if (!vp && vn) return InputSelection::BLUETOOTH;
  else if (vp && !vn) return InputSelection::USB;
  else return InputSelection::ERROR_STATE;
}

void enterState(InputSelection s) {
  switch (s) {
    case InputSelection::OFF: enterOffMode(); break;
    case InputSelection::BLUETOOTH: enterBluetoothMode(); break;
    case InputSelection::USB: enterUsbMode(); break;
    case InputSelection::ERROR_STATE: enterErrorMode(); break;
  }
}

void exitState(InputSelection s) {
  switch (s) {
    case InputSelection::OFF: exitOffMode(); break;
    case InputSelection::BLUETOOTH: exitBluetoothMode(); break;
    case InputSelection::USB: exitUsbMode(); break;
    case InputSelection::ERROR_STATE: exitErrorMode(); break;
  }
}

void runState(InputSelection s) {
  switch (s) {
    case InputSelection::OFF: runOffMode(); break;
    case InputSelection::BLUETOOTH: runBluetoothMode(); break;
    case InputSelection::USB: runUsbMode(); break;
    case InputSelection::ERROR_STATE: runErrorMode(); break;
  }
}

// =======================================================================
// OFF MODE
// =======================================================================

void enterOffMode() {
  load_config(OFF_CONFIG);
  display.update("", "", 300);
}

void exitOffMode() {}

void runOffMode() {}

// =======================================================================
// BLUETOOTH MODE
// =======================================================================

void avrc_rn_playstatus_callback(esp_avrc_playback_stat_t playback) {
  bt_is_playing = (playback == ESP_AVRC_PLAYBACK_PLAYING);
}

void avrc_metadata_callback(uint8_t id, const uint8_t* text) {
  String metadata = String((char*)text);

  switch (id) {
    case ESP_AVRC_MD_ATTR_TITLE:
      metadata.replace(" • Lossless", "");
      currentTrack.title = AutocastDisplay::asciiIfy(metadata);
      break;
    case ESP_AVRC_MD_ATTR_ARTIST:
      metadata.replace(" • Lossless", "");
      currentTrack.artist = AutocastDisplay::asciiIfy(metadata);
      break;
  }
}

void connection_state_changed(esp_a2d_connection_state_t state, void* ptr) {
  if (state == ESP_A2D_CONNECTION_STATE_CONNECTED) {
    bt_is_connected = true;
    bt_display_information = BT_NOW_PLAYING;
  } else if (state == ESP_A2D_CONNECTION_STATE_DISCONNECTED) {
    bt_is_connected = false;
    bt_is_playing = false;
    bt_display_information = BT_NOT_CONNECTED;
  }
}

void audio_state_changed(esp_a2d_audio_state_t state, void* ptr) {
  switch (state) {
    case ESP_A2D_AUDIO_STATE_STARTED:
      bt_is_playing = true;
      bt_display_information = BT_NOW_PLAYING;
      break;
    default:  // SUSPENDED / STOPPED (older core versions: REMOTE_SUSPEND)
      bt_is_playing = false;
      break;
  }
}

void enterBluetoothMode() {
  load_config(BLUETOOTH_CONFIG);
  bt_is_connected = false;
  bt_is_playing = false;
  syncButtonStates();

  i2s_pin_config_t pin_config = {
    .bck_io_num = 26,
    .ws_io_num = 25,
    .data_out_num = 22,
    .data_in_num = I2S_PIN_NO_CHANGE
  };
  a2dp_sink.set_pin_config(pin_config);

  a2dp_sink.set_on_connection_state_changed(connection_state_changed);
  a2dp_sink.set_avrc_metadata_callback(avrc_metadata_callback);
  a2dp_sink.set_on_audio_state_changed(audio_state_changed);
  a2dp_sink.set_avrc_rn_playstatus_callback(avrc_rn_playstatus_callback);
  a2dp_sink.start("Mazda 323", true);

  bt_last_volume = bt_current_volume = a2dp_sink.get_volume();
  bt_display_information = BT_NOT_CONNECTED;
  bt_overlay_on = false;
  currentTrack.title = "";
  currentTrack.artist = "";
}

void exitBluetoothMode() {
  // Tear down the A2DP sink so re-entering BLUETOOTH mode later starts clean.
  a2dp_sink.end(false);
  delay(200);  // try at enterBluetooth or at runBluetooth if better performance has been proven that way
}

static void changeVolume(int delta) {
  int v = (int)a2dp_sink.get_volume() + delta;
  a2dp_sink.set_volume((uint8_t)constrain(v, 0, 127));  // clamp: avoids uint8 wrap-around
}

static void handleButtonAction(uint8_t pin) {
  if (pin == BT_BTN_PREV) a2dp_sink.previous();
  else if (pin == BT_BTN_NEXT) a2dp_sink.next();
  else if (pin == BT_BTN_VOL_UP) changeVolume(+BT_VOLUME_STEP);
  else if (pin == BT_BTN_VOL_DOWN) changeVolume(-BT_VOLUME_STEP);
  else if (pin == BT_BTN_PLAYPAUSE) {
    if (bt_is_playing) {
      a2dp_sink.pause();
      bt_is_playing = false;
    } else {
      a2dp_sink.play();
      bt_is_playing = true;
    }
  }
}

// Call once on mode entry so a button held during the mode switch doesn't fire.
static void syncButtonStates() {
  for (int i = 0; i < 5; i++) {
    btn_last[i] = (digitalRead(BT_BUTTON_PINS[i]) == BUTTON_ACTIVE_LEVEL);
  }
}

static void handleBluetoothButtons() {
  unsigned long now = millis();

  for (int i = 0; i < 5; i++) {
    uint8_t pin = BT_BUTTON_PINS[i];
    bool pressed = (digitalRead(pin) == BUTTON_ACTIVE_LEVEL);

    if (pressed && !btn_last[i]) {
      // Rising edge: a fresh press
      btn_press_time[i] = now;
      btn_last_repeat[i] = now;
      if (bt_is_connected) handleButtonAction(pin);  // same guard as the old isConnected check
    } else if (pressed && btn_last[i] && (pin == BT_BTN_VOL_UP || pin == BT_BTN_VOL_DOWN) && now - btn_press_time[i] > BT_REPEAT_DELAY_MS && now - btn_last_repeat[i] > BT_REPEAT_INTERVAL_MS) {
      // Held volume button: auto-repeat
      btn_last_repeat[i] = now;
      if (bt_is_connected) handleButtonAction(pin);
    }

    btn_last[i] = pressed;
  }
}

void runBluetoothMode() {

  digitalWrite(DIMM_DISPLAY_PIN, digitalRead(ILLUMINATION_SIGNAL_PIN));
  handleBluetoothButtons();

  bt_current_volume = a2dp_sink.get_volume();

  if (bt_current_volume != bt_last_volume) {
    bt_display_information = BT_VOLUME_OVERLAY;
    bt_last_volume = bt_current_volume;
    bt_overlay_timestamp = millis();
  }

  switch (bt_display_information) {
    case BT_NOT_CONNECTED:
      bt_top_display_content = "   Ready to";
      bt_bottom_display_content = "   connect";
      break;

    case BT_NOW_PLAYING:
      bt_top_display_content = currentTrack.title;
      bt_bottom_display_content = currentTrack.artist;

      if (bt_top_display_content.length() < 1 && bt_bottom_display_content.length() < 1) {
        bt_top_display_content = "    Device";
        bt_bottom_display_content = "   connected";
      }
      break;

    case BT_VOLUME_OVERLAY:
      if (bt_overlay_on) {
        if (millis() - bt_overlay_timestamp > BT_OVERLAY_DURATION_MS) {
          bt_overlay_on = false;
          bt_display_information = BT_NOW_PLAYING;
        }
      } else {
        bt_overlay_on = true;
        bt_overlay_timestamp = millis();
      }

      bt_top_display_content = "Volume";
      bt_bottom_display_content = "[";

      for (int i = 0; i < bt_current_volume; i += 11) {
        bt_bottom_display_content += "-";
      }
      for (int i = bt_bottom_display_content.length(); i < 13; i++) {
        bt_bottom_display_content += " ";
      }
      bt_bottom_display_content += "]";
      break;
  }

  display.update(bt_top_display_content, bt_bottom_display_content, 300);

  delay(10);  // paces display refresh / BT servicing, mirrors original loop cadence
}

// =======================================================================
// USB MODE
// =======================================================================

void enterUsbMode() {
  load_config(USB_CONFIG);
}

void exitUsbMode() {}

void runUsbMode() {
  digitalWrite(DIMM_DISPLAY_PIN, digitalRead(ILLUMINATION_SIGNAL_PIN));

  static int dac_enabled = 0;
  int cable_present = digitalRead(USB_DAC_CABLE_DETECT_A) || digitalRead(USB_DAC_CABLE_DETECT_B);

  if (cable_present && !dac_enabled) {
    enable_usb_dac();
    dac_enabled = 1;
  } else if (!cable_present && dac_enabled) {
    disable_usb_dac();
    dac_enabled = 0;
  }

  delay(100);
  Wire.beginTransmission(INA226_ADDR);
  delay(100);
  if (Wire.endTransmission() != 0) {
    success = 0;
  } else {
    success = 1;
  }

  setupINA226();

  int16_t rawShunt = ina226Read16(INA226_REG_SHUNT_V);
  int16_t rawBus = ina226Read16(INA226_REG_BUS_V);
  int16_t rawCurr = ina226Read16(INA226_REG_CURRENT);
  int16_t rawPower = ina226Read16(INA226_REG_POWER);

  float shuntVoltage_mV = rawShunt * 0.0025f;  // LSB = 2.5uV
  float busVoltage_V = rawBus * 0.00125f;      // LSB = 1.25mV
  float current_mA = rawCurr * INA226_currentLSB * 1000.0f;
  float power_mW = rawPower * INA226_powerLSB * 1000.0f;

  char charging_string[32];
  sprintf(charging_string, "%.2f A %.2f W", current_mA / 1000, power_mW / 1000);
  display.update(success ? "Charging with" : "Error", charging_string, 300);
}

// =======================================================================
// ERROR MODE
// =======================================================================

void enterErrorMode() {
  display.update("Failed to read", "selection", 300);
}

void exitErrorMode() { /* clear fault indication */
}

void runErrorMode() { /* e.g. blink an error LED */
}

// =======================================================================
// SETUP / LOOP
// =======================================================================

void setup() {
  // Buttons
  pinMode(USER_BUTTON_1, INPUT);
  pinMode(USER_BUTTON_2, INPUT);
  pinMode(USER_BUTTON_3, INPUT);
  pinMode(USER_BUTTON_4, INPUT);
  pinMode(USER_BUTTON_5, INPUT);


  // Configuration register
  pinMode(CONFIG_PIN_SER, OUTPUT);
  pinMode(CONFIG_PIN_SRCLK, OUTPUT);
  pinMode(CONFIG_PIN_RCLK, OUTPUT);

  digitalWrite(CONFIG_PIN_SER, LOW);
  digitalWrite(CONFIG_PIN_SRCLK, LOW);
  digitalWrite(CONFIG_PIN_RCLK, LOW);

  // Input selector
  pinMode(SENSOR_VP_PIN, INPUT);
  pinMode(SENSOR_VN_PIN, INPUT);

  // Display dimming
  pinMode(ILLUMINATION_SIGNAL_PIN, INPUT);
  pinMode(DIMM_DISPLAY_PIN, OUTPUT);

  // USB cable detect
  pinMode(USB_DAC_CABLE_DETECT_A, INPUT);
  pinMode(USB_DAC_CABLE_DETECT_B, INPUT);

  // Amplifier failure
  pinMode(AMP_FAIL_PIN, INPUT);

  // Display hardware is shared across modes, so it's brought up once here
  // rather than inside any single mode's entry point.
  display.begin(5, 18, -1, 23);  // no miso. pin 19 used for something else. fix later

  // Prime the state machine with an immediate (un-debounced) read so we
  // start in a sensible state rather than always booting into OFF.
  int vp = digitalRead(SENSOR_VP_PIN);
  int vn = digitalRead(SENSOR_VN_PIN);
  autocast_input_selection = decodeState(vp, vn);
  candidateState = autocast_input_selection;
  debounceCounter = DEBOUNCE_THRESHOLD;

  Wire.begin(USB_POWER_MONITOR_SDA_PIN, USB_POWER_MONITOR_SCL_PIN);
  Wire.setClock(50000);  // 50kHz, because the wiring is a bit loose

  // Check device is present
  delay(100);
  Wire.beginTransmission(INA226_ADDR);
  delay(100);
  if (Wire.endTransmission() != 0) {
    success = 0;
  } else {
    success = 1;
  }

  setupINA226();

  enterState(autocast_input_selection);
}

void loop() {
  unsigned long now = millis();

  // Only sample the pins at a fixed cadence; do real work every loop.
  if (now - lastSampleTime >= SAMPLE_INTERVAL_MS) {
    lastSampleTime = now;

    int vpState = digitalRead(SENSOR_VP_PIN);
    int vnState = digitalRead(SENSOR_VN_PIN);
    InputSelection sampled = decodeState(vpState, vnState);

    if (sampled == candidateState) {
      // Reading agrees with our running candidate: count it, capped at
      // the threshold so the counter can't overflow over a long stable run.
      if (debounceCounter < DEBOUNCE_THRESHOLD) {
        debounceCounter++;
      }
    } else {
      // Reading disagrees: start a fresh count for the new candidate.
      candidateState = sampled;
      debounceCounter = 1;
    }

    // Commit the transition only once the candidate has been stable for
    // DEBOUNCE_THRESHOLD consecutive samples.
    if (debounceCounter >= DEBOUNCE_THRESHOLD && candidateState != autocast_input_selection) {
      exitState(autocast_input_selection);
      autocast_input_selection = candidateState;
      enterState(autocast_input_selection);
    }
  }

  runState(autocast_input_selection);
}
