adrianhelfer/Autocast/(commit log)

2025-06-30 before attempt to fix annotation
    [Display.kicad_sch]
2025-06-30 cascade digits
    [Digit.kicad_sch, Display.kicad_sch]
2025-07-07 quick save
    [Digit.kicad_sch, Display.kicad_sch]
2025-07-07 add mounting holes
2025-07-08 clean switch symbols
2025-07-09 add 3D Models
    [12402032E202A.STEP, 2004850460.stp, ACPSX04-41.STEP, TL2230EEF100.STEP]
2025-07-09 add C Part #
    [Digit.kicad_sch]
2025-07-09 First JLC upload
    [bom.csv, designators.csv, positions.csv]
2025-07-12 user save
    [Amplifier.kicad_sch, I2S_DAC.kicad_sch, Shunt.kicad_sch]
2025-07-14 draw schematic
    [12402032E202A.STEP, PSU_EVT.kicad_pcb, PSU_EVT.kicad_sch, STL6P3LLH6.step]
2025-07-14 Order RC
    [PSU_EVT.kicad_pcb, bom.csv, designators.csv, positions.csv]
2025-07-16 ready to route
    [Playback_Control_EVT.kicad_pcb, Playback_Control_EVT.kicad_sch]
2025-08-10 add BOM
    [PSU_EVT.csv, Playback_Control_EVT.csv, Playback_Control_EVT.kicad_pcb, Playback_Control_EVT.kicad_sch]
2025-10-16 remove unused top label
    [Display_Control_EVT.kicad_pcb]
2025-11-19 order V1
    [bom.csv, designators.csv, positions.csv]
2025-11-19 Add DigiKey BOM
    [bom.csv]
2026-09-19 update kicad version and switch #
    [Digit.kicad_sch, Display.kicad_pcb, Display.kicad_sch]
2026-09-19 update ordering numbers
    [Digit.kicad_sch, Display.kicad_pcb, Display.kicad_sch]
2026-09-21 Beta Milestone
    USB DAC activation not working properly yet. IO19 falsely occupied as Display MISO. Bluetooth not (dis-)engaging properly on mode switch - Power reset required.
    [Autocast.ino]
2026-09-21 B+ width adjusted
    [Systemboard.kicad_pcb]
2026-09-22 Beta 2
    USB DAC seems to be recognized by phone and laptop in any orientation at any selection. The DAC should get enabled only in USB mode so far and only one side of the detection is implemented yet. usb_dac_en line in schematic works as expected. DAC IC gets power regardless of the state of the voltage regulator. Probably getting powered by the phone.
    Probably still worth implementing the side A detection too to avoid draining the phone, although that could result in a much higher drain by unmatched voltages on the same line.
    Bluetooth auto-reconnect possible?
    [Autocast.ino]
2026-09-22 implement cable detect
2026-09-22 auto-reconnect
    auto connects to the last device at power up but not when the state is switched away from bluetooth and back. at this stage the last device does not auto-reconnect but also no new device can establish a new connection. old coupled device has to manually disconnect first.
2026-09-22 fix amp pullup value
    was too high. amp was not turning on
    [Amplifier.kicad_sch, Systemboard.kicad_pcb]
2026-10-06 user save
    slight adjustments to mechanical parts. prepare several input pins
    [carriage_attachment-Body.stl, carriage_attachment.FCStd, carriage_attachment.step, potentiometer_attachment-Body.stl, potentiometer_attachment.step]
2026-10-08 add button caps
    [forward.FCStd, forward.stl, minus.FCStd, minus.stl, play-pause.FCStd, play-pause.stl, plus.FCStd, plus.stl]
2026-10-08 add display glass
    [Display-Assembly.FCStd, Display-Assembly.stl, Display-Glass.FCStd, Display-Glass.stl]
